lairdrt/door-protective-sleeve/exports/sleeve.3mf

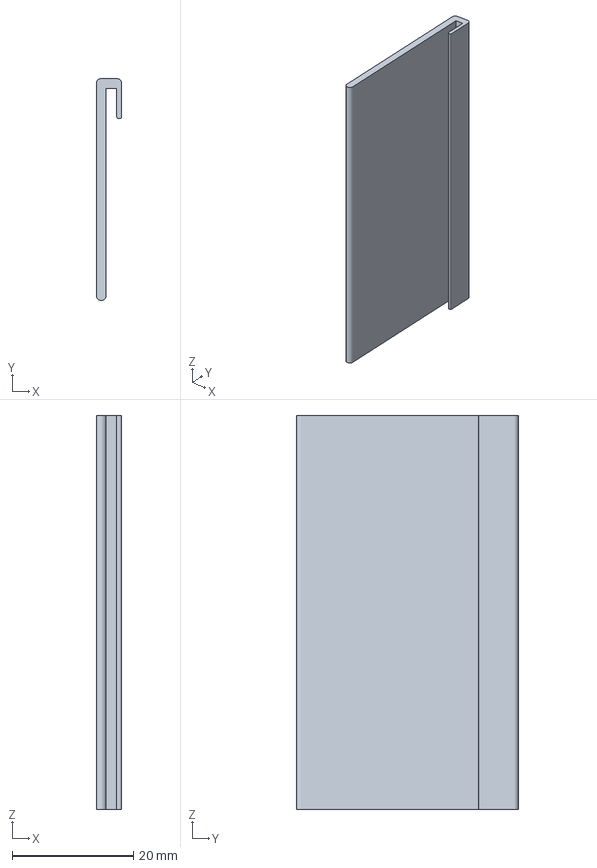
[picture p5: CAD file, 2026-10-10]
exports/sleeve.3mf
4.15 x 36.6 x 65.0 mm
