lairdrt/door-protective-sleeve/exports/sleeve-test.3mf

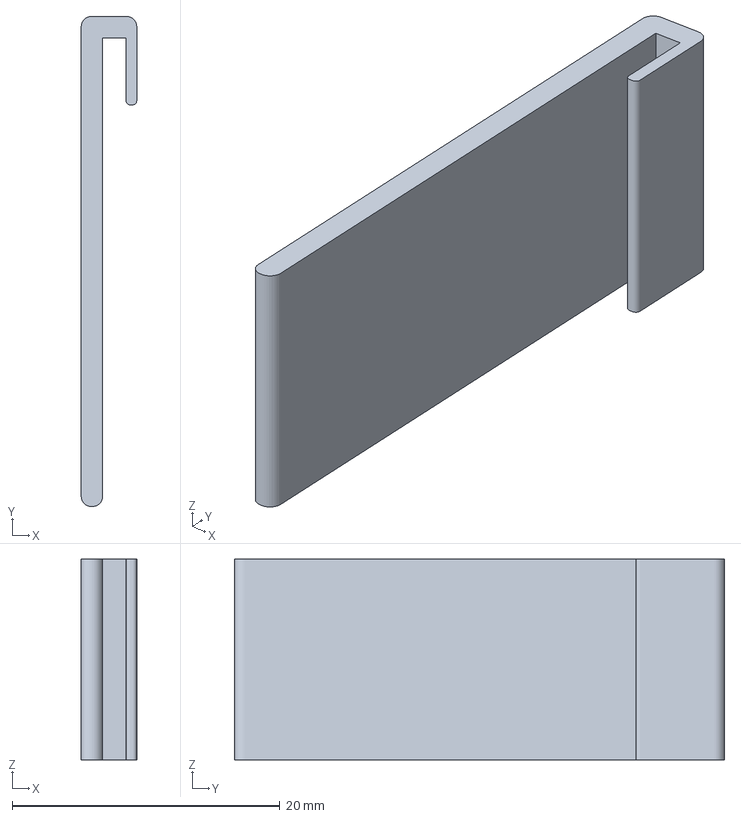
[picture p6: CAD file, 2026-10-10]
exports/sleeve-test.3mf
4.15 x 36.6 x 15.0 mm
