lairdrt/door-protective-sleeve/(list of files, cad)

Other CAD files:
exports/sleeve-test.stl
exports/sleeve.stl
