lairdrt/door-protective-sleeve/photos/sleeve-test-iso.png

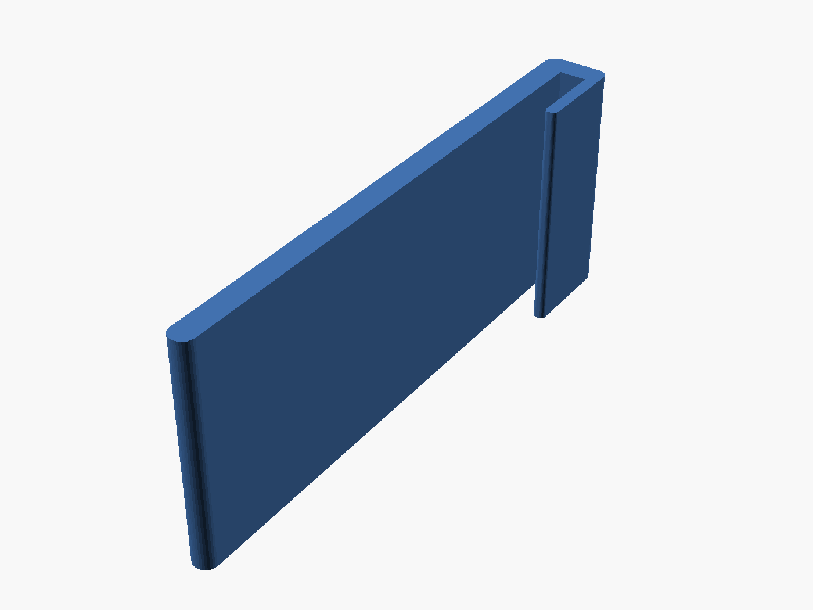
photos/sleeve-test-iso.png
