lairdrt/door-protective-sleeve/photos/sleeve-test-tongue.png

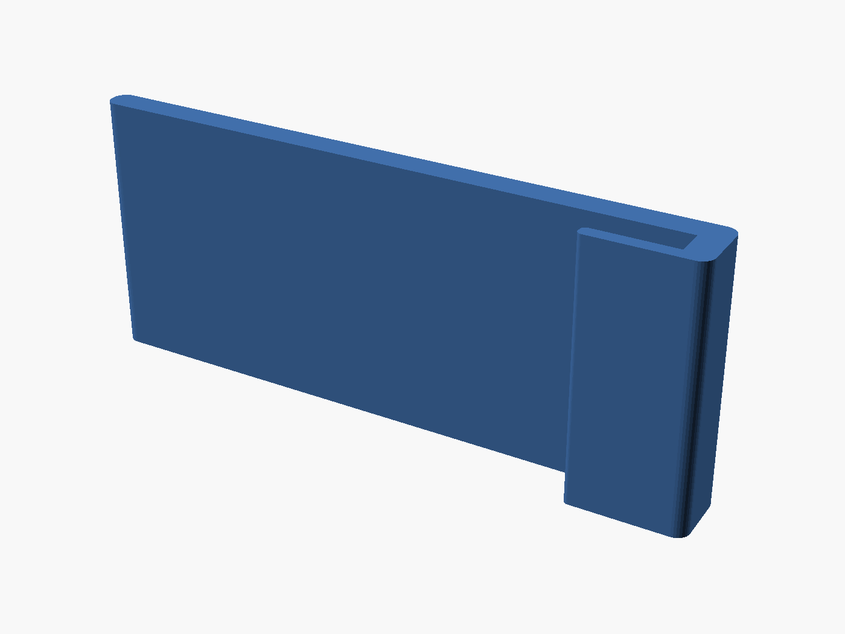
photos/sleeve-test-tongue.png
