lairdrt/door-protective-sleeve/(commit log)

2026-10-10 Initial parametric OpenSCAD door protective sleeve
    U-shaped sleeve (grip face, edge bridge, retaining tongue) for the
    worn aluminum sliding-door edge, with 15 mm fit-test specimen
    exports. Dimensions are proposed starting values, not yet
    physically verified.
    [sleeve-test.3mf, sleeve-test.stl, sleeve.scad]
2026-10-10 Finalize synchronized 65mm sleeve model and drawings
    [sleeve-drawing.scad, sleeve-test.3mf, sleeve.3mf, sleeve.scad, sleeve.stl]
